buteomont/Delivery-Box-Reporter/resources/kicad/delivery-box-reporter/delivery-box-reporter.png

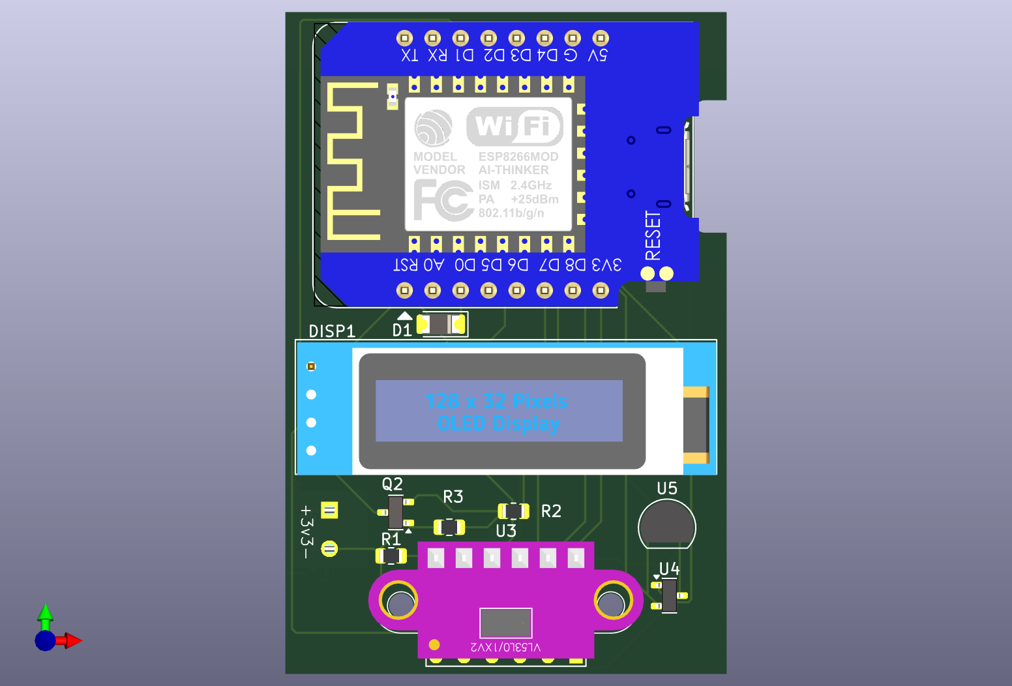
resources/kicad/delivery-box-reporter/delivery-box-reporter.png
