buteomont/Delivery-Box-Reporter/resources/TLV803E typical application.png

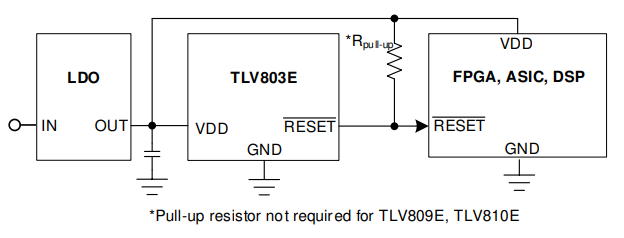
resources/TLV803E typical application.png
