buteomont/Delivery-Box-Reporter/resources/FreeCAD/DeliveryBoxReporter-Top.stl

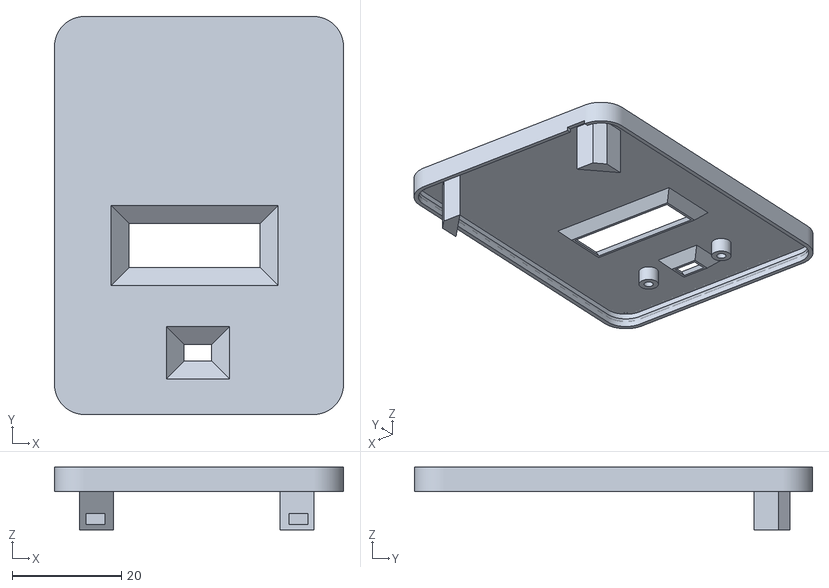
[picture p3: CAD file, 2024-12-18]
resources/FreeCAD/DeliveryBoxReporter-Top.stl
53.0 x 73.0 x 11.5
