buteomont/Delivery-Box-Reporter/resources/FreeCAD/sensorShim.FCStd

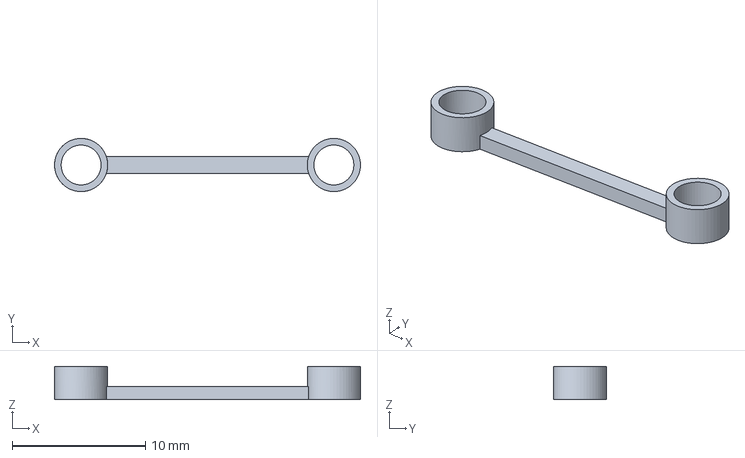
[picture p4: CAD file, 2024-12-18]
resources/FreeCAD/sensorShim.FCStd
23.0 x 4.00 x 2.50 mm
