buteomont/Delivery-Box-Reporter/resources/FreeCAD/DeliveryBoxReporter-Bottom.stl

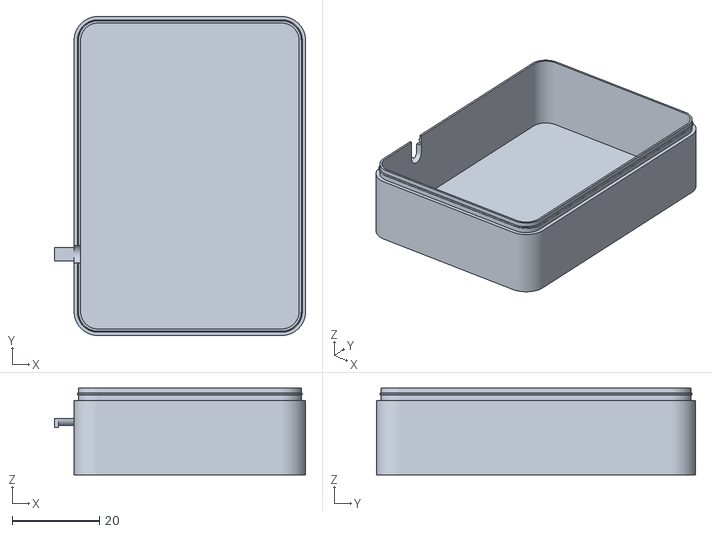
[picture p5: CAD file, 2024-12-18]
resources/FreeCAD/DeliveryBoxReporter-Bottom.stl
57.5 x 73.0 x 19.9
