buteomont/Delivery-Box-Reporter/resources/FreeCAD/displayShim.FCStd

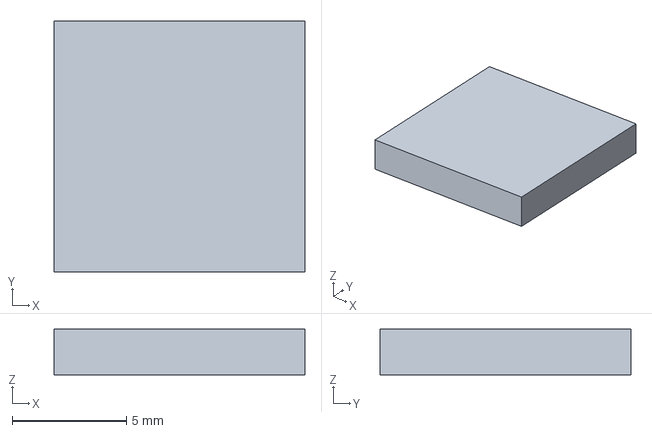
[picture p6: CAD file, 2024-12-18]
resources/FreeCAD/displayShim.FCStd
11.0 x 11.0 x 2.00 mm
