buteomont/Delivery-Box-Reporter/resources/FreeCAD/DeliveryBoxReporter.FCStd

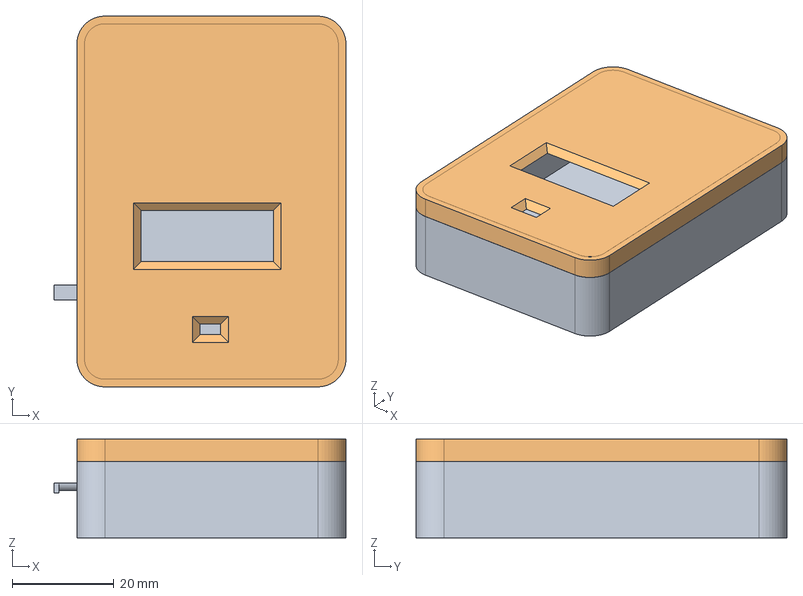
[picture p7: CAD file, 2024-12-16]
resources/FreeCAD/DeliveryBoxReporter.FCStd
57.5 x 73.0 x 19.5 mm
BottomBody
TopBody
