buteomont/Delivery-Box-Reporter/resources/FreeCAD/DeliveryBoxReporter (copy).FCStd

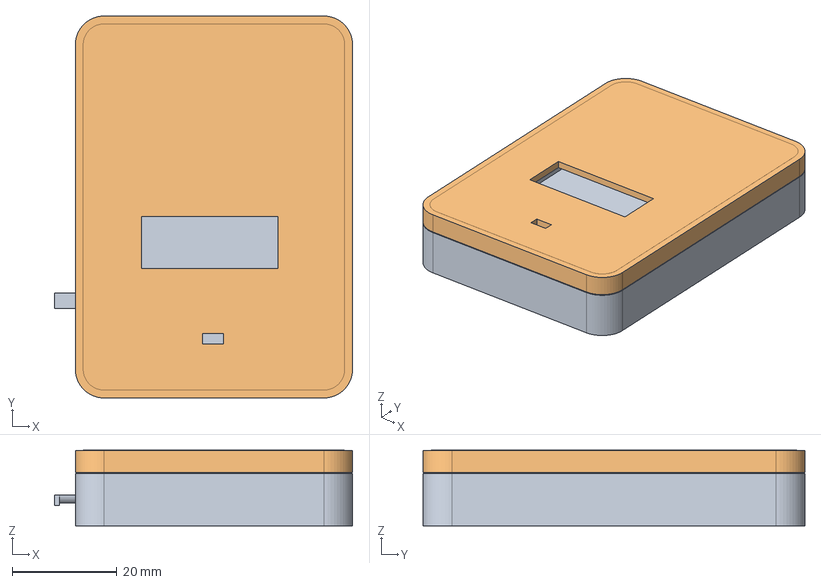
[picture p8: CAD file, 2024-12-16]
resources/FreeCAD/DeliveryBoxReporter (copy).FCStd
57.0 x 73.0 x 14.5 mm
BottomBody
TopBody
