buteomont/Delivery-Box-Reporter/(list of files, cad)

Other CAD files:
resources/FreeCAD/displayShim.stl
resources/FreeCAD/sensorShim.stl
