buteomont/Delivery-Box-Reporter/resources/kicad/delivery-box-reporter/delivery-box-reporter.kicad_pcb

## KiCad design resources/kicad/delivery-box-reporter/delivery-box-reporter.kicad_pcb (2024-12-18)

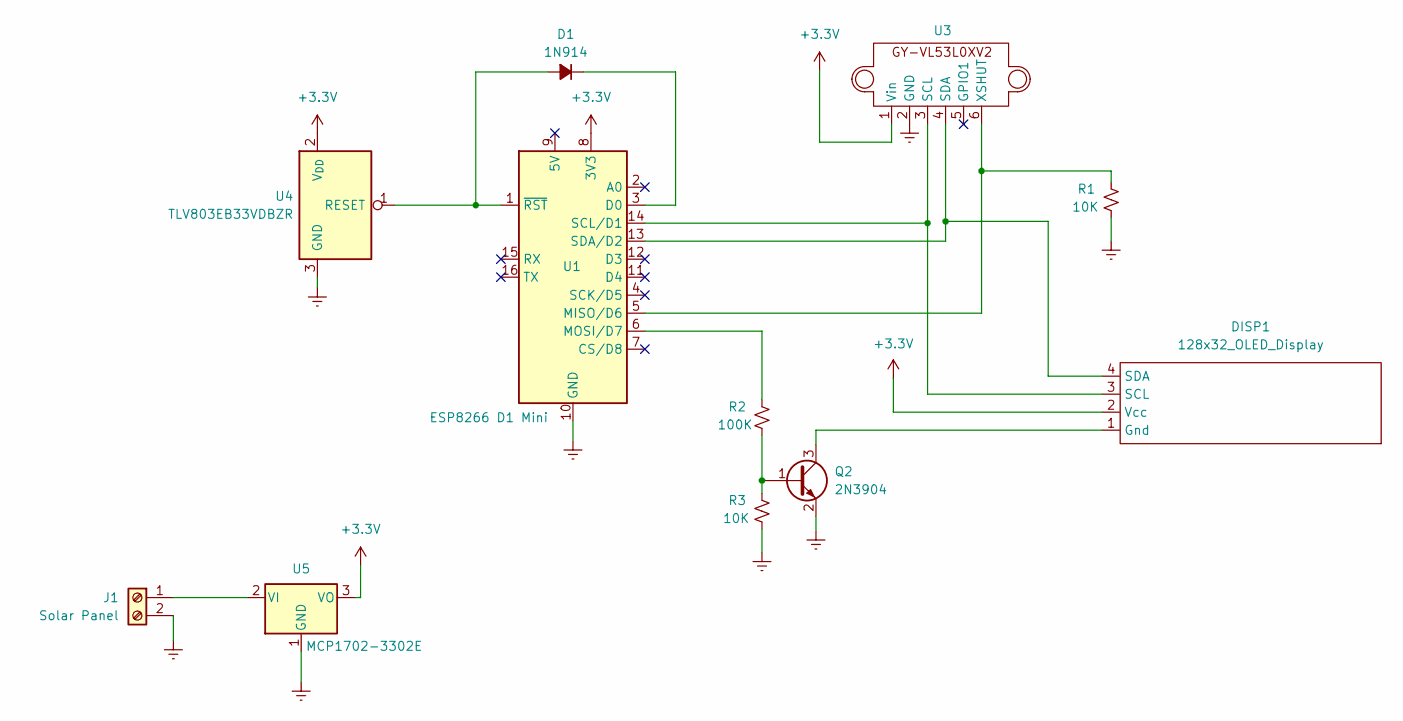
[picture p9: schematic delivery-box-reporter.kicad_sch]

Parts:
D1: 1N914; R_0805_2012Metric
DISP1: 128x32_OLED_Display; OLED_0.91_128x32
J1: Solar Panel; KF350 2 Pin Terminal Block
Q2: 2N3904; MMBT3904-7-F_SOT-23-3
R1, R3: 10K; R_0805_2012Metric
R2: 100K; R_0805_2012Metric
U1: ESP8266 D1 Mini; WEMOS_D1_mini_light
U3: GY-VL53LOX-V2
U4: TLV803EB33VDBZR; SOT-23
U5: MCP1702-3302E; TO-92_Inline

Connections:
+3.3V: DISP1.2 (Vcc), U1.8 (3V3), U3.1 (Vin), U4.2 (V_{DD}), U5.3 (VO); also elsewhere on the board
Earth: J1.2, Q2.2 (E), R1.1, R3.1, U1.10 (GND), U3.2 (GND), U4.3 (GND), U5.1 (GND); also elsewhere on the board
unnamed: D1.2 (A), U1.1 (~RST), U4.1 (RESET)
unnamed: D1.1 (K), U1.3 (D0)
unnamed: DISP1.1 (Gnd), Q2.3 (C)
unnamed 5: DISP1.3 (SCL), U1.14 (SCL/D1), U3.3 (SCL); also elsewhere on the board
unnamed 6: DISP1.4 (SDA), U1.13 (SDA/D2), U3.4 (SDA); also elsewhere on the board
unnamed: J1.1, U5.2 (VI)
unnamed: Q2.1 (B), R2.1, R3.2
unnamed 9: R1.2, U1.5 (MISO/D6), U3.6 (XSHUT); also elsewhere on the board
unnamed: R2.2, U1.6 (MOSI/D7)

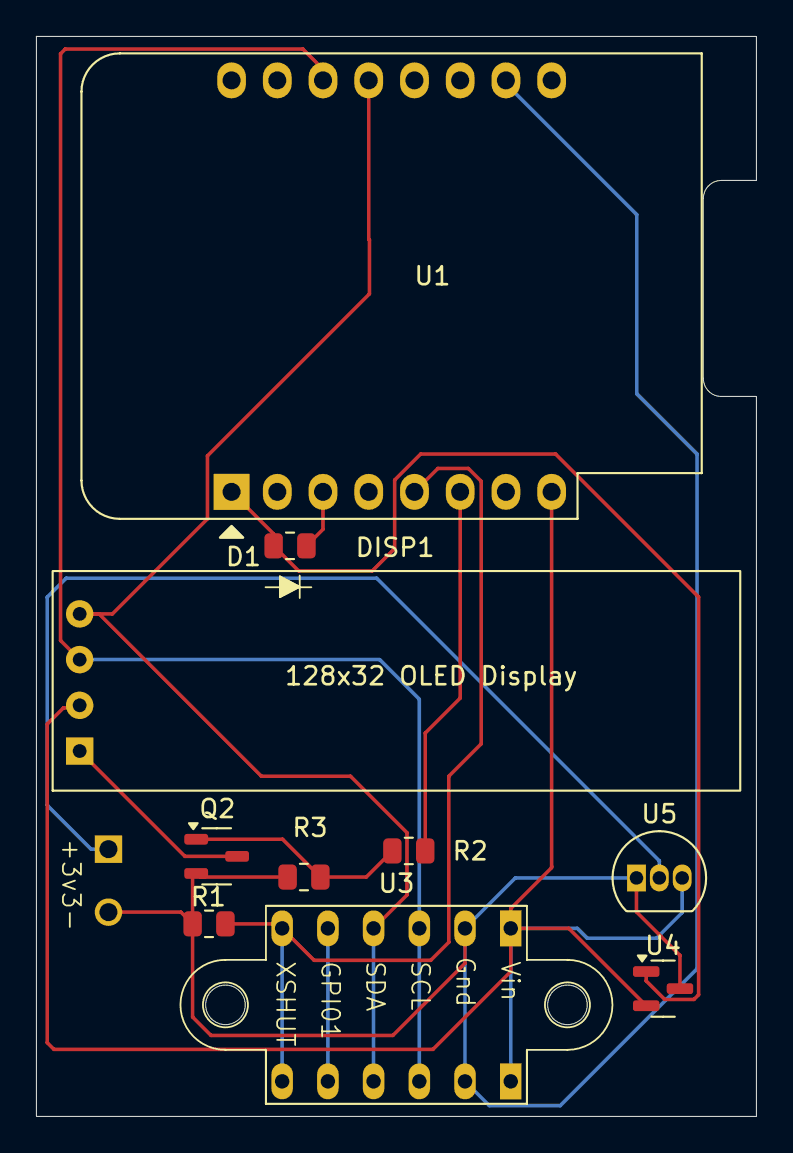
[picture p10: board delivery-box-reporter.kicad_pcb from above]

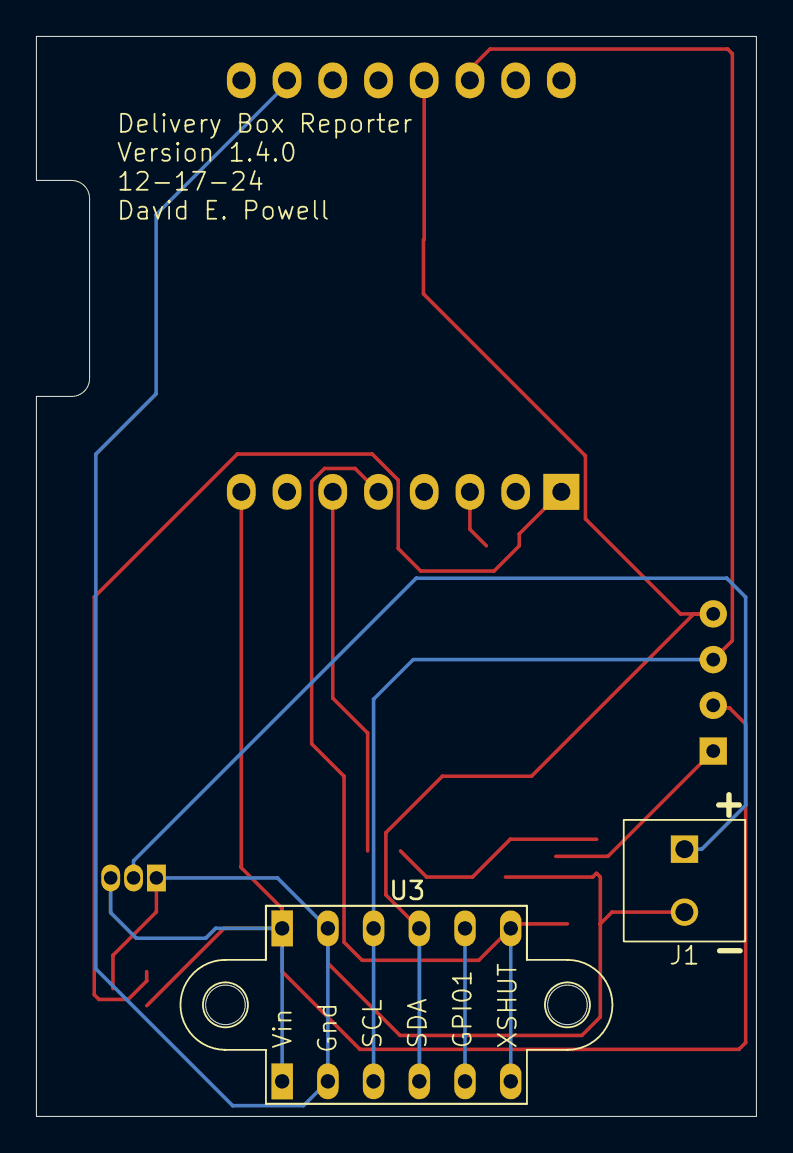
[picture p11: board delivery-box-reporter.kicad_pcb from below]

Board: 2 copper layers, 40.0 x 60.0 mm, 12 parts (2 on the bottom side), 11 nets.

Other parts of the board:
U3#2: GY-VL53LOX-V2

Their connections:
+3.3V: U3#2.1 (Vin); also elsewhere on the board
Earth: U3#2.2 (GND); also elsewhere on the board
unnamed 5: U3#2.3 (SCL); also elsewhere on the board
unnamed 6: U3#2.4 (SDA); also elsewhere on the board
unnamed 9: U3#2.6 (XSHUT); also elsewhere on the board
