buteomont/Delivery-Box-Reporter/(commit log)

2024-12-02 Remove ignored files from version control
    [delivery-box-reporter-B_Cu.gbr, delivery-box-reporter-B_Mask.gbr, delivery-box-reporter-B_Silkscreen.gbr, delivery-box-reporter-Edge_Cuts.gbr, delivery-box-reporter-F_Cu.gbr, delivery-box-reporter-F_Mask.gbr, delivery-box-reporter-F_Silkscreen.gbr, delivery-box-reporter-NPTH.drl]
2024-12-02 removed ignored files
    [delivery-box-reporter-B_Cu.gbr, delivery-box-reporter-B_Mask.gbr, delivery-box-reporter-B_Silkscreen.gbr, delivery-box-reporter-Edge_Cuts.gbr, delivery-box-reporter-F_Cu.gbr, delivery-box-reporter-F_Mask.gbr, delivery-box-reporter-F_Silkscreen.gbr, delivery-box-reporter-NPTH.drl]
2024-12-16 Updated PCB
    [DeliveryBoxReporter (copy).FCStd, DeliveryBoxReporter-Bottom.stl, DeliveryBoxReporter-top.stl, DeliveryBoxReporter.FCStd, delivery-box-reporter.kicad_pcb]
2024-12-18 Changes to board and minor code changes.
    [BOM.tsv, DeliveryBoxReporter-Bottom.stl, DeliveryBoxReporter-Top.stl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]
2024-12-18 Combined overloaded show() functions
    [delivery-box-reporter.kicad_sch]
2024-12-18 Added funtion to invert the display
    [main.cpp]
2024-12-21 Clear rtc timer every hour
2024-12-21 A bug in loop() prevented distance check
    [main.cpp]
